ger1964jou/autoodin/(list of files, drawings)

Other design files:
PCB/Control Board mark 1.pcb
PCB/Control Board mark 2.pcb
PCB/OD_mark3_development.pcb
PCB/OD_mark4.pcb
PCB/OD_mark4_revised.pcb
PCB/OD_mark4_revision2.pcb
